SKZ81/AutoWatS_moisture_sensor/docs/pinout_atmega88.jpg

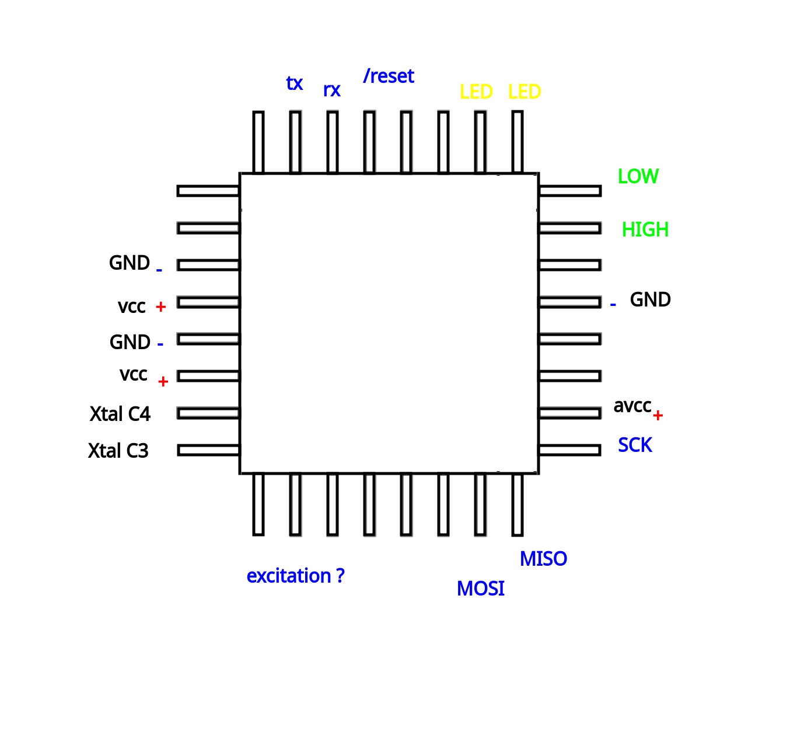
docs/pinout_atmega88.jpg
