SKZ81/AutoWatS_moisture_sensor/Simulation/simulation.png

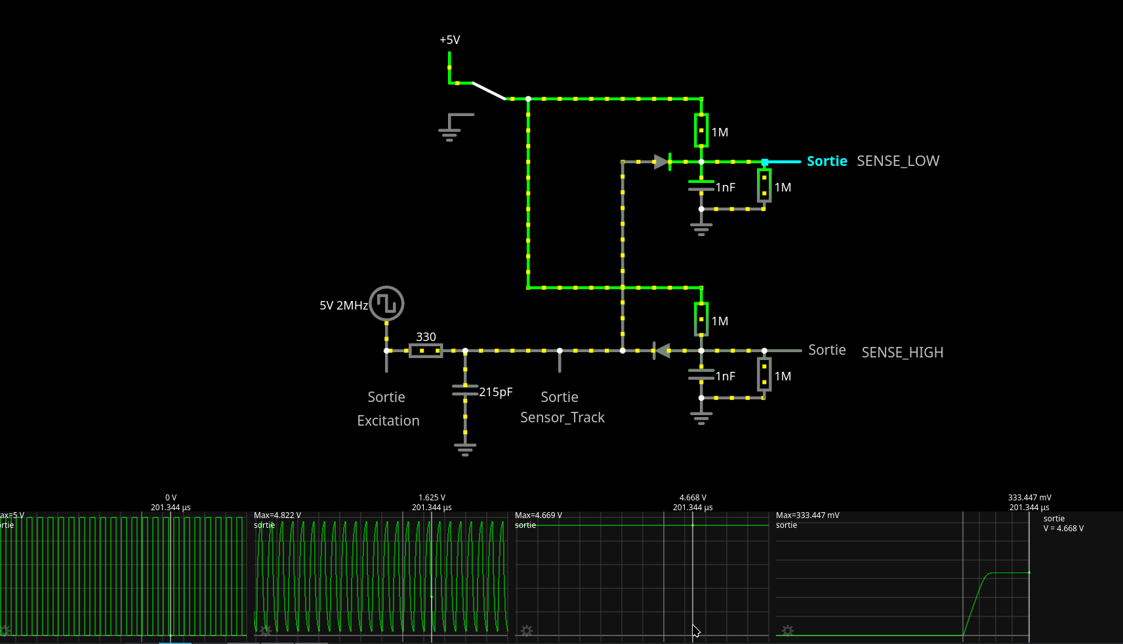
Simulation/simulation.png
