SKZ81/AutoWatS_moisture_sensor/KiCAD/AutoWatS_moisture.kicad_sch

## KiCad design KiCAD/AutoWatS_moisture.kicad_sch (2026-08-14)

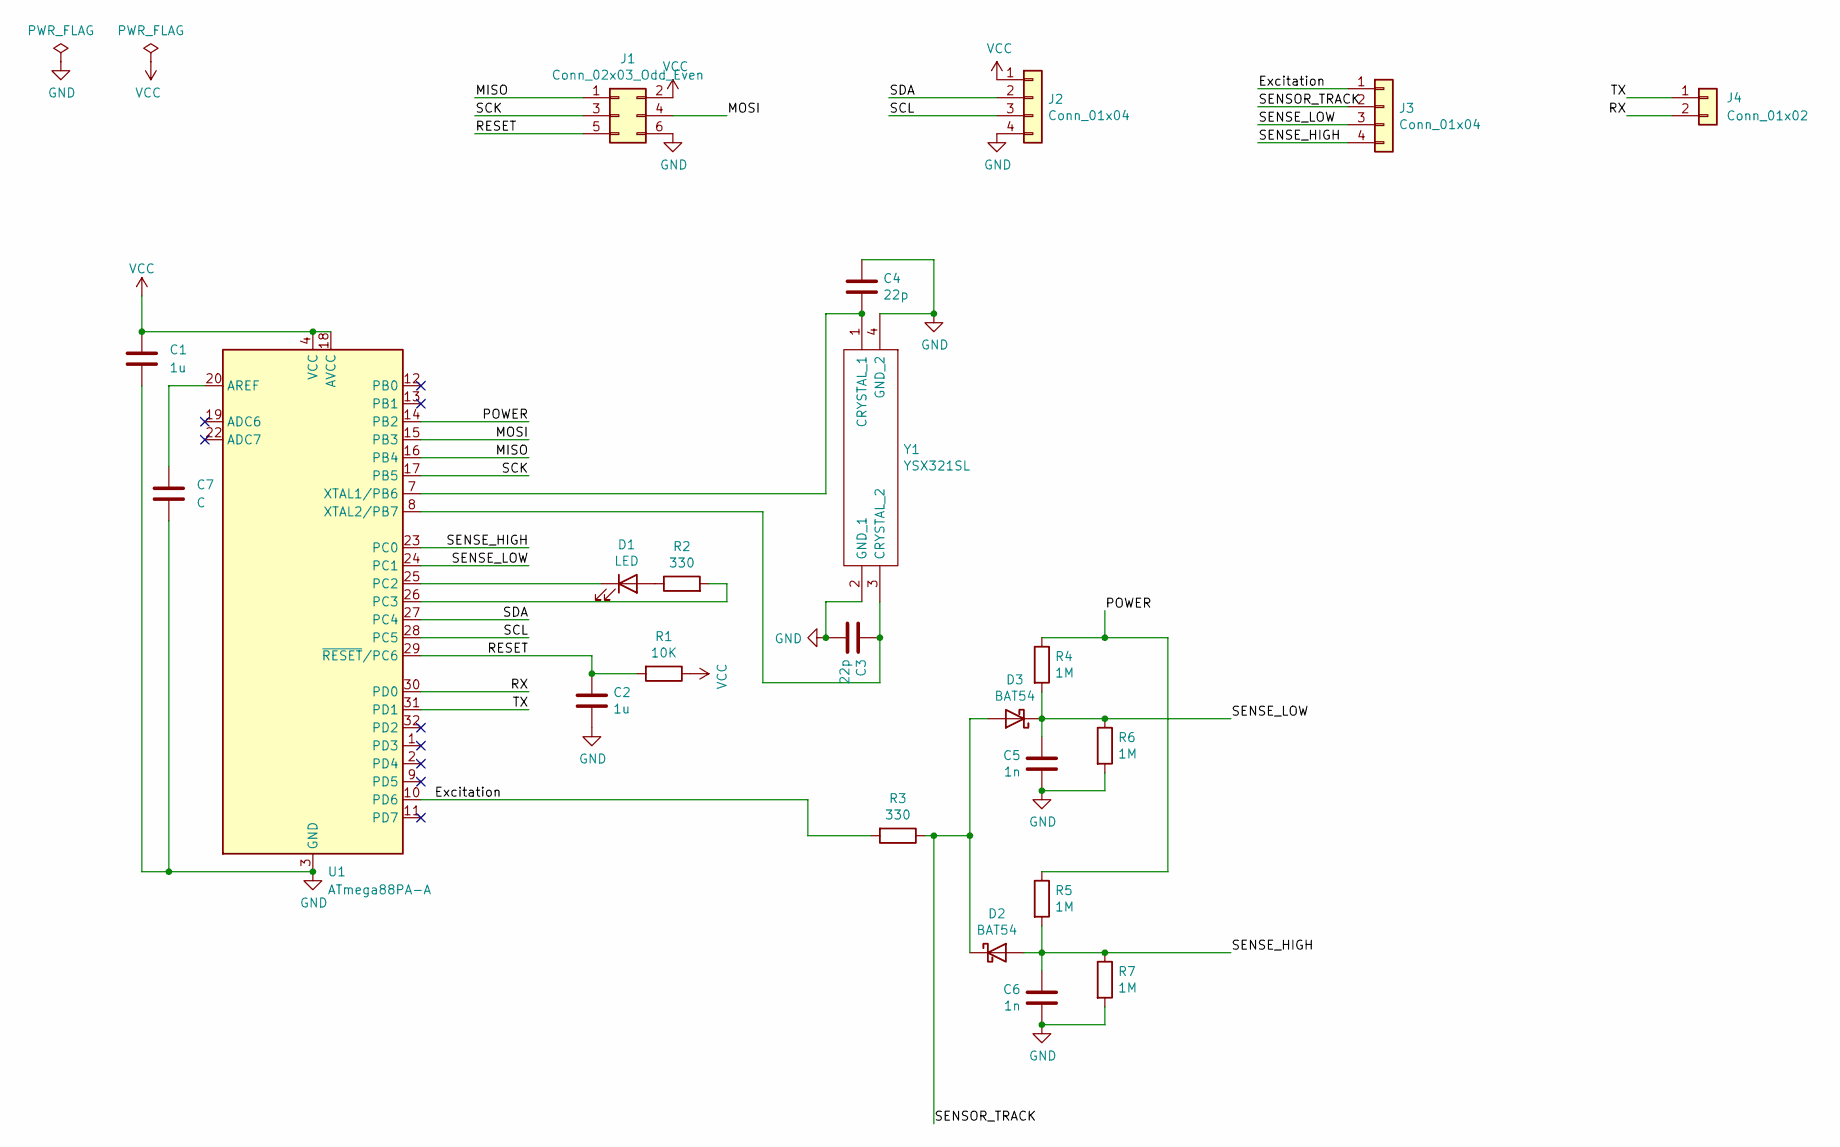
[picture p3: schematic AutoWatS_moisture.kicad_sch]

Parts:
C1, C2: 1u; C_0805_2012Metric; LCSC Part C28323
C3, C4: 22p; C_0805_2012Metric; LCSC Part C1804
C5, C6: 1n; C_0805_2012Metric; LCSC Part C46653
C7: C; C_0402_1005Metric
D1: LED; LED_0805_2012Metric; LCSC Part C34499
D2: BAT54; D_SOD-123; LCSC C8598
D3: BAT54; D_SOD-123; LCSC Part C8598
J1: Conn_02x03_Odd_Even; PinHeader_2x03_P2.54mm_Vertical
J2, J3: Conn_01x04; PinHeader_1x04_P2.54mm_Vertical
J4: Conn_01x02; PinHeader_1x02_P2.54mm_Vertical
R1: 10K; R_0805_2012Metric; LCSC Part C17414
R2, R3: 330; R_0805_2012Metric; LCSC Part C17630
R4, R5, R6, R7: 1M; R_0805_2012Metric; LCSC Part C17514
U1: ATmega88PA-A; TQFP-32_7x7mm_P0.8mm
Y1: YSX321SL; Manufacturer_Part_Number YSX321SL; LCSC Part C13738

Connections:
Excitation: J3.1, R3.2, U1.10 (PD6)
GND: C1.2, C2.2, C3.2, C4.1, C5.1, C6.1, C7.2, J1.6, J2.4, R6.2, R7.2, U1.3 (GND), U1.5 (GND), U1.21 (GND), Y1.2 (GND_1), Y1.4 (GND_2)
MISO: J1.1, U1.16 (PB4)
MOSI: J1.4, U1.15 (PB3)
unnamed: C3.1, U1.8 (XTAL2/PB7), Y1.3 (CRYSTAL_2)
unnamed: C4.2, U1.7 (XTAL1/PB6), Y1.1 (CRYSTAL_1)
unnamed: C7.1, U1.20 (AREF)
unnamed: D1.1 (K), U1.25 (PC2)
unnamed: D1.2 (A), R2.1
unnamed: R2.2, U1.26 (PC3)
POWER: R4.1, R5.1, U1.14 (PB2)
RESET: C2.1, J1.5, R1.2, U1.29 (~RESET/PC6)
RX: J4.2, U1.30 (PD0)
SCK: J1.3, U1.17 (PB5)
SCL: J2.3, U1.28 (PC5)
SDA: J2.2, U1.27 (PC4)
SENSE_HIGH: C6.2, D2.2 (A), J3.4, R5.2, R7.1, U1.23 (PC0)
SENSE_LOW: C5.2, D3.1 (K), J3.3, R4.2, R6.1, U1.24 (PC1)
SENSOR_TRACK: D2.1 (K), D3.2 (A), J3.2, R3.1
TX: J4.1, U1.31 (PD1)
VCC: C1.1, J1.2, J2.1, R1.1, U1.4 (VCC), U1.6 (VCC), U1.18 (AVCC)
