SKZ81/AutoWatS_moisture_sensor/(commit log)

2026-08-14 Big messy commit
    [AutoWatS_moisture.kicad_sch]
2026-09-18 Added set_frequency debug command in test firmware
    Also switched to PGM space strings for most of traces
2026-09-18 Enabled on-board crystal for full 16MHz CPU frequency
2026-09-18 Fix excitation signal generation
    Mainly, do not actually "sleep" while ADC (it disables the counter then the signal's oscillation).
    [main_moisture.c]
2026-09-18 Fixed capacitance measurement
2026-09-18 Fixed light measurement routine : restore cathode as output
    [main_moisture.c]
2026-09-21 Fix reset watchdog bug and adcReadChannel() bug
    [main_moisture.c]
2026-09-22 Improved traces
2026-09-22 Use same command number as Miceuz device
    As per [Miceuz](https://github.com/Miceuz) own [i2c-moisture-sensor](https://github.com/Miceuz/i2c-moisture-sensor) (see [code here](https://github.com/Miceuz/i2c-moisture-sensor/blob/c687328d2fdbe45b1b6c9d6b92627460e9f3167d/src/main.c#L26) ).
2026-09-22 Added I2C GET EXCITATION FREQUENCY command
